fschroer/steam-pigeon-locator-hardware/BOM/RocketLocatorBOM.xlsx

Sheet: JLCPCB Upload
Comment | Designator | Footprint | JLCPCB Part #（optional）
2.2uF | C15,C16,C21 | C_0402_1005Metric | C307418
10nF | C17 | C_0402_1005Metric | C15195
10uF | C32,C37 | C_0402_1005Metric | C15525
1uF | C2,C3,C4,C5,C11,C12,C13,C14,C18,C38 | C_0402_1005Metric | C52923
0.1uF | C1,C6,C7,C8,C9,C10,C20,C36 | C_0402_1005Metric | C1525
47uF | C26 | C_1206_3216Metric | C96123
4.7uF | C19 | C_0402_1005Metric | C368809
Green LED | D1 | LED_0402_1005Metric | C965794
LED_XL-Z1912RGBA-SG | D4,D5 | LED_XL-Z1912RGBA-SG | C22461785
USB_C | J1 | USB_C_Receptacle_Palconn_UTC16-G | C2927038
U.FL-R-SMT(01) | J7 | HRS_U.FL-R-SMT(01) | C5137195
2N7002KN | Q1 | DFN1006-3L | C49009905
BSS84 | Q3 | DFN1006-3L | C42394022
PMXB43UNE | Q4,Q5,Q6,Q7 | Nexperia_DFN1010D-3_SOT1215 | C547273
5.1K | R10,R25 | R_0402_1005Metric | C294638
27K 0.1% | R11 | R_0402_1005Metric | C25207446
33 | R15 | R_0402_1005Metric | C25105
620 | R2,R18,R24,R36,R38 | R_0402_1005Metric | C4961
1M | R3,R17,R30 | R_0402_1005Metric | C26083
470 | R32 | R_0402_1005Metric | C25117
120 | R33,R34 | R_0402_1005Metric | C25079
47K | R27,R28,R37,R39 | R_0402_1005Metric | C25792
10K | R1,R12,R23,R26,R31,R40,R41 | R_0402_1005Metric | C25531
4.7K | R21,R22 | R_0402_1005Metric | C25900
100 | R4,R16,R19,R35,R43,R45,R46,R47,R48 | R_0402_1005Metric | C25076
47 | R5,R13,R14 | R_0402_1005Metric | C25118
220 | R6 | R_0402_1005Metric | C25091
374 | R7 | R_0402_1005Metric | C48971914
13K | R8 | R_0402_1005Metric | C25754
8.2K 0.1% | R9 | R_0402_1005Metric | C24265089
100K | R20,R29,R42,R44,R49,R50,R51,R52 | R_0402_1005Metric | C25741
1K | R53,R54,R55,R56 | R_0402_1005Metric | C11702
TPS22950YBHR | U1,U6,U8,U9,U15 | IC_TPS22950YBHR | C3230039
PAM8904EGPR | U11 | W-QFN2020-12-EP(2x2) | C510550
SN74HCS00BQA-Q1 | U12 | WQFN 14 3.00 mm × 2.50 mm | C4469587
DMP2021UFDF | U13 | Diodes_UDFN2020-6_Type-F | C151459
ISM6HG256XTR | U14 | U_LGA-14L_2p5X3p0X0p83_STM | C51931514
MS5611-01BA | U16 | LGA-8_3x5mm_P1.25mm | C15639
MX25L6436F | U17 | SOP-8_5.28x5.23mm_P1.27mm | C2830754
BQ25185DLHR | U18 | BQ25185DLHR | C19725033
SAM-M10Q-00B | U2 | XCVR_SAM-M10Q-00B | C5443880
DRV5032DUDMRR | U3 | X2SON | C2152495
CH340N | U4 | JEITA_SOIC-8_3.9x4.9mm_P1.27mm | C2977777
STM32WL5MOCH6TR | U5 | LGA-92_10X10_STM | C22363244
RT9080-33GJ5 | U7 | SOT94P280X100-5N | C841192
MMC5983MA | U19 | LGA-16_3x3mm_P0.5mm | C404329

Sheet: RocketLocator
Id | Designator | Footprint | Quantity | Comment | JLCPCB Part #（optional） | Type | Unit Cost | Total | Quantity on Hand | Attrition Quantity | Quantity Needed | Gap | Quantity Ordered | Order Status | Lead Time Estimate | Notes
1 | C15,C16,C21 | C_0402_1005Metric | 3 | 2.2uF | C307418 | Extended | 0.022 | $0.07 | 210 | 10 | 100 |  |  |  |  | X5R
2 | C17 | C_0402_1005Metric | 1 | 10nF | C15195 | Basic | 0.0041 | $0.0041 | 60 | 10 | 40 |  |  |  |  | X7R
3 | C32,C37 | C_0402_1005Metric | 2 | 10uF | C15525 | Basic | 0.0257 | $0.05 | 930 | 10 | 70 |  |  |  |  | X5R
4 | C2,C3,C4,C5,C11,C12,C13,C14,C18,C38 | C_0402_1005Metric | 10 | 1uF | C52923 | Basic | 0.0075 | $0.07 | 480 | 10 | 310 |  |  |  |  | X5R
5 | C1,C6,C7,C8,C9,C10,C20,C36 | C_0402_1005Metric | 8 | 0.1uF | C1525 | Basic | 0.0055 | $0.04 | 300 | 10 | 250 |  |  |  |  | X7R
6 | C26 | C_1206_3216Metric | 1 | 47uF | C96123 | Basic | 0.168 | $0.17 | 150 | 4 | 34 |  |  |  |  | X5R; JLCPCB now lists as Basic (was Extended)
7 | C19 | C_0402_1005Metric | 1 | 4.7uF | C368809 | Extended | 0.0157 | $0.02 | 500 |  | 30 |  |  |  |  | X5R
8 | D1 | LED_0402_1005Metric | 1 | Green LED | C965794 | Extended | 0.013 | $0.01 | 400 | 10 | 40
9 | D4,D5 | LED_XL-Z1912RGBA-SG | 2 | LED_XL-Z1912RGBA-SG | C22461785 | Extended | 0.0158 | $0.03 | 72 | 4 | 64 |  |  |  |  | JLCPCB part is XL-Z1921RGBA-SG; KiCad value/footprint say XL-Z1912RGBA-SG
10 | H1,H2,H3,H4 | MountingHole_2.2mm_M2 | 4 | MountingHole | N/A |  |  | $0.00 |  |  | 0
11 | J1 | USB_C_Receptacle_Palconn_UTC16-G | 1 | USB_C | C2927038 | Extended | 0.0635 | $0.06 | 257 |  | 30
12 | J12 | PinHeader_1x06_P2.54mm_Vertical_Pos4-5_Empty | 1 | Battery / Switch | N/A |  |  | $0.00 |  |  | 0
13 | J2 | PinHeader_1x04_P2.54mm_Vertical | 1 | Deploy Ch1 / Ch2 | N/A |  |  | $0.00 |  |  | 0
14 | J4 | PinHeader_1x04_P2.54mm_Vertical | 1 | Deploy Ch3 / Ch4 | N/A |  |  | $0.00 |  |  | 0
15 | J7 | HRS_U.FL-R-SMT(01) | 1 | U.FL-R-SMT(01) | C5137195 | Extended | 0.0417 | $0.04 | 279 |  | 30
16 | J8 | SAMTEC_FTR-107-51-G-D | 1 | Conn_ST_STDC14 | N/A |  |  | $0.00 |  |  | 0
17 | LS1 | PiezoBuzzer | 1 | SPKR | N/A |  |  | $0.00 |  |  | 0
18 | Q1 | DFN1006-3L | 1 | 2N7002KN | C49009905 | Extended | 0.0218 | $0.02 | 75 | 5 | 35
19 | Q3 | DFN1006-3L | 1 | BSS84 | C42394022 | Extended | 0.0403 | $0.04 | 42 | 4 | 34
20 | Q4,Q5,Q6,Q7 | Nexperia_DFN1010D-3_SOT1215 | 4 | PMXB43UNE | C547273 | Extended | 0.5428 | $2.17 |  | 4 | 124 | 124 |  |  |  | New: deploy low-side FETs (Topology A); PMXB43UNEZ, unit cost is LCSC 100+ price (Oct 2026)
21 | R10,R25 | R_0402_1005Metric | 2 | 5.1K | C294638 | Extended | 0.0014 | $0.0028 | 2930 | 10 | 70
22 | R11 | R_0402_1005Metric | 1 | 27K 0.1% | C25207446 | Extended | 0.0203 | $0.02 | 100 | 0 | 30
23 | R15 | R_0402_1005Metric | 1 | 33 | C25105 | Basic | 0.0011 | $0.0011 | 80 | 10 | 40 |  |  |  |  | Schematic value 35
24 | R2,R18,R24,R36,R38 | R_0402_1005Metric | 5 | 620 | C4961 | Extended | 0.0019 | $0.01 | 150 | 10 | 160 | 10
25 | R3,R17,R30 | R_0402_1005Metric | 3 | 1M | C26083 | Basic | 0.0015 | $0.0045 | 150 | 10 | 100
26 | R32 | R_0402_1005Metric | 1 | 470 | C25117 | Basic | 0.0012 | $0.0012 | 74 | 10 | 40
27 | R33,R34 | R_0402_1005Metric | 2 | 120 | C25079 | Basic | 0.0034 | $0.01 | 890 | 10 | 70
28 | R27,R28,R37,R39 | R_0402_1005Metric | 4 | 47K | C25792 | Basic | 0.002 | $0.01 | 150 | 10 | 130
29 | R1,R12,R23,R26,R31,R40,R41 | R_0402_1005Metric | 7 | 10K | C25531 | Extended | 0.0026 | $0.02 | 9705 | 12 | 222
30 | R21,R22 | R_0402_1005Metric | 2 | 4.7K | C25900 | Basic | 0.0021 | $0.0042 | 970 | 10 | 70
31 | R4,R16,R19,R35,R43,R45,R46,R47,R48 | R_0402_1005Metric | 9 | 100 | C25076 | Basic | 0.0012 | $0.01 | 960 | 10 | 280 |  |  |  |  | Schematic values R16=109, R19=98; R45-R48 are deploy FET gate resistors
32 | R5,R13,R14 | R_0402_1005Metric | 3 | 47 | C25118 | Extended | 0.0012 | $0.0036 | 2940 | 12 | 102
33 | R6 | R_0402_1005Metric | 1 | 220 | C25091 | Basic | 0.0018 | $0.0018 | 3030 | 10 | 40 |  |  |  |  | Schematic value 218
34 | R7 | R_0402_1005Metric | 1 | 374 | C48971914 | Extended | 0.0006 | $0.0006 | 60 | 10 | 40 |  |  |  |  | Schematic value 375
35 | R8 | R_0402_1005Metric | 1 | 13K | C25754 | Extended | 0.0023 | $0.0023 | 60 | 10 | 40
36 | R9 | R_0402_1005Metric | 1 | 8.2K 0.1% | C24265089 | Extended | 0.0213 | $0.02 | 100 | 10 | 40
37 | R20,R29,R42,R44,R49,R50,R51,R52 | R_0402_1005Metric | 8 | 100K | C25741 | Basic | 0.0015 | $0.01 | 4960 | 10 | 250 |  |  |  |  | R20 was 1M before Topology A; R49-R52 are deploy FET gate pulldowns
38 | R53,R54,R55,R56 | R_0402_1005Metric | 4 | 1K | C11702 | Basic | 0.0013 | $0.01 |  | 10 | 130 | 130 |  |  |  | New: DEPLOY1+..4+ bleeders (Topology A); unit cost is LCSC 100+ price (Oct 2026)
39 | U1,U6,U8,U9,U15 | IC_TPS22950YBHR | 5 | TPS22950YBHR | C3230039 | Extended | 0.5919 | $2.96 | 120 | 0 | 150 | 30
40 | U11 | W-QFN2020-12-EP(2x2) | 1 | PAM8904EGPR | C510550 | Extended | 0.3336 | $0.33 | 30 | 0 | 30
41 | U12 | WQFN 14 3.00 mm × 2.50 mm | 1 | SN74HCS00BQA-Q1 | C4469587 | Extended | 0.3679 | $0.37 | 50 | 0 | 30 |  |  |  |  | Replacing C295467
42 | U13 | Diodes_UDFN2020-6_Type-F | 1 | DMP2021UFDF | C151459 | Extended | 0.7504 | $0.75 | 0 | 0 | 30 | 30 | 34
43 | U14 | U_LGA-14L_2p5X3p0X0p83_STM | 1 | ISM6HG256XTR | C51931514 | Extended | 14.1006 | $14.10 | 30 | 0 | 30
44 | U16 | LGA-8_3x5mm_P1.25mm | 1 | MS5611-01BA | C15639 | Extended | 5.467 | $5.47 | 30 | 0 | 30
45 | U17 | SOP-8_5.28x5.23mm_P1.27mm | 1 | MX25L6436F | C2830754 | Extended | 2.0322 | $2.03 | 30 | 0 | 30
46 | U18 | BQ25185DLHR | 1 | BQ25185DLHR | C19725033 | Extended | 1.1346 | $1.13 | 0 | 0 | 30 | 30 | 30
47 | U2 | XCVR_SAM-M10Q-00B | 1 | SAM-M10Q-00B | C5443880 | Extended | 20.5582 | $20.56 | 30 | 0 | 30
48 | U3 | X2SON | 1 | DRV5032DUDMRR | C2152495 | Extended | 0.2927 | $0.29 | 60 | 0 | 30
49 | U4 | JEITA_SOIC-8_3.9x4.9mm_P1.27mm | 1 | CH340N | C2977777 | Extended | 0.4284 | $0.43 | 30 | 0 | 30
50 | U5 | LGA-92_10X10_STM | 1 | STM32WL5MOCH6TR | C22363244 | Extended | 24.6878 | $24.69 | 30 | 0 | 30
51 | U7 | SOT94P280X100-5N | 1 | RT9080-33GJ5 | C841192 | Extended | 0.1196 | $0.12 | 127 | 0 | 30
52 | U19 | LGA-16_3x3mm_P0.5mm | 1 | MMC5983MA | C404329 | Extended | 1.843 | $1.84 |  | 0 | 30 |  |  |  |  | Added 2026-10-21: magnetometer on I2C2 (0x30)

Sheet: Assumptions
Next production run quantity | 30
Unit cost source | JLCPCB parts API, 2026-10-21; price tier for each row's Quantity Needed (USD)
