fschroer/steam-pigeon-locator-hardware/RocketLocator.kicad_pcb

## KiCad design RocketLocator.kicad_pcb (2026-10-25)

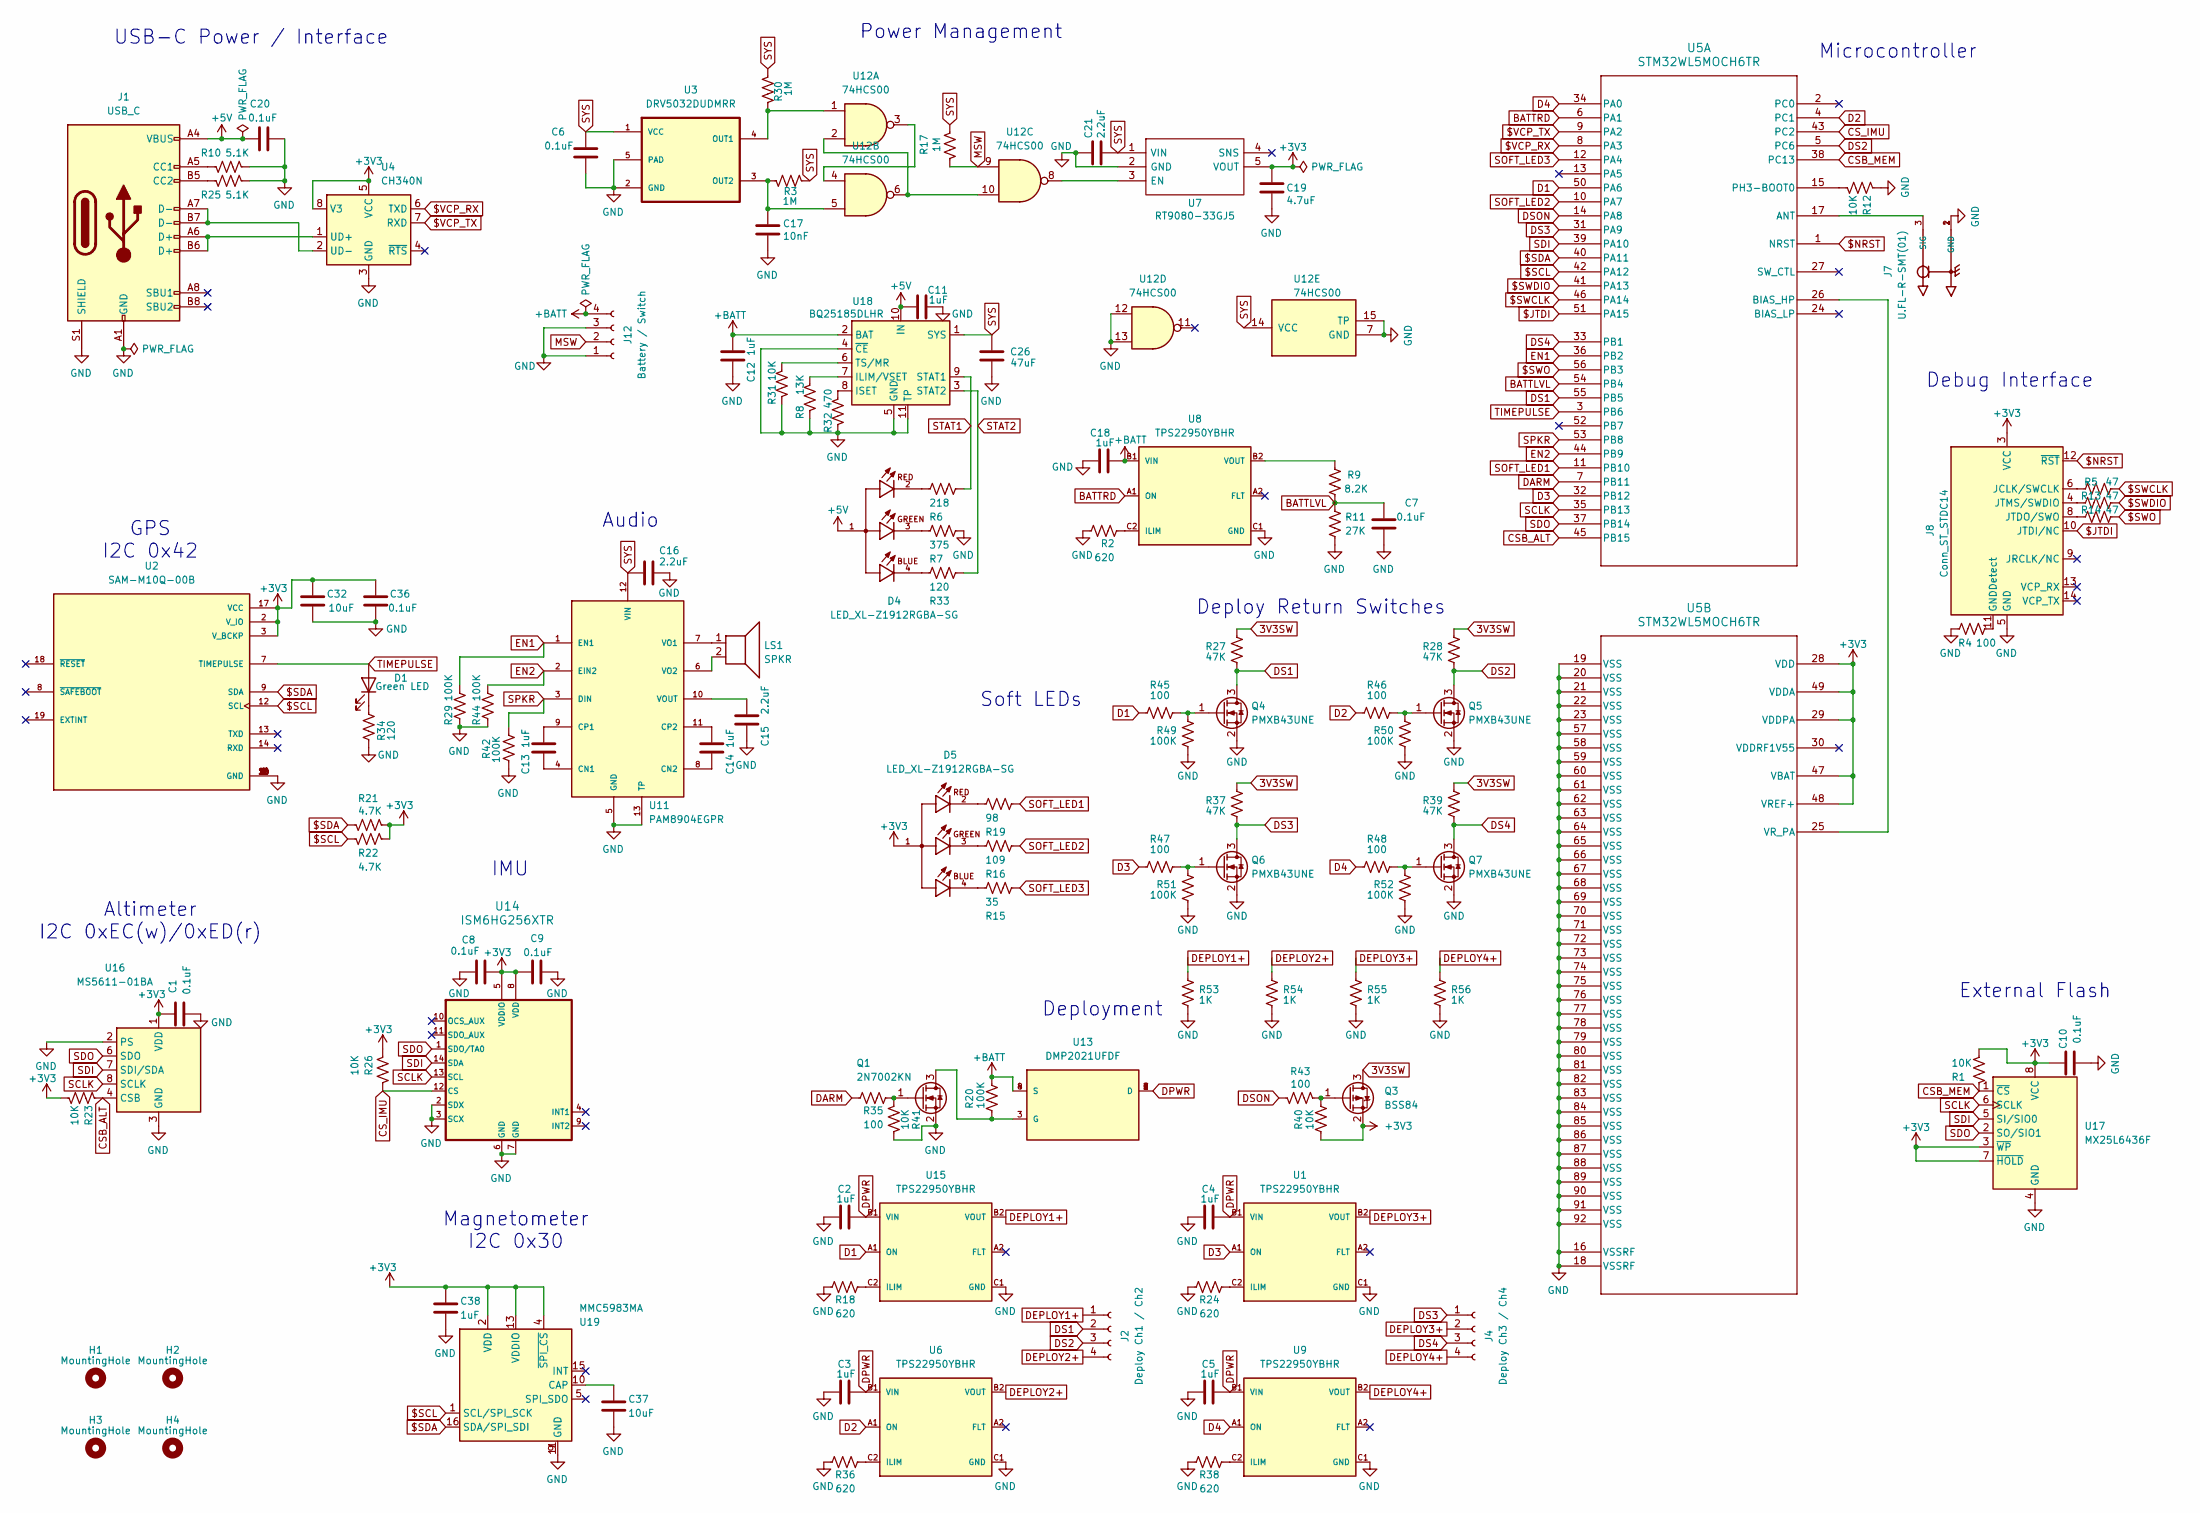
[picture p1: schematic RocketLocator.kicad_sch]

Parts:
C1, C6, C7, C8, C9, C10, C20, C36: 0.1uF; C_0402_1005Metric
C2, C3, C4, C5, C11, C12, C13, C14, C18, C38: 1uF; C_0402_1005Metric
C15, C16, C21: 2.2uF; C_0402_1005Metric
C17: 10nF; C_0402_1005Metric
C19: 4.7uF; C_0402_1005Metric
C26: 47uF; C_1206_3216Metric
C32, C37: 10uF; C_0402_1005Metric
D1: Green LED; LED_0402_1005Metric
D4, D5: LED_XL-Z1912RGBA-SG
H1, H2, H3, H4: MountingHole; MountingHole_2.2mm_M2
J1: USB_C; USB_C_Receptacle_Palconn_UTC16-G
J2: Deploy Ch1 / Ch2; PinHeader_1x04_P2.54mm_Vertical
J4: Deploy Ch3 / Ch4; PinHeader_1x04_P2.54mm_Vertical
J7: U.FL-R-SMT(01); HRS_U.FL-R-SMT(01)
J8: Conn_ST_STDC14; SAMTEC_FTR-107-51-G-D
J12: Battery / Switch; PinHeader_1x06_P2.54mm_Vertical_Pos4-5_Empty
LS1: SPKR; PiezoBuzzer
Q1: 2N7002KN; DFN1006-3L
Q3: BSS84; DFN1006-3L
Q4, Q5, Q6, Q7: PMXB43UNE; Nexperia_DFN1010D-3_SOT1215
R1, R12, R23, R26, R31, R40, R41: 10K; R_0402_1005Metric
R2, R18, R24, R36, R38: 620; R_0402_1005Metric
R3, R17, R30: 1M; R_0402_1005Metric
R4, R35, R43, R45, R46, R47, R48: 100; R_0402_1005Metric
R5, R13, R14: 47; R_0402_1005Metric
R6: 218; R_0402_1005Metric
R7: 375; R_0402_1005Metric
R8: 13K; R_0402_1005Metric
R9: 8.2K; R_0402_1005Metric
R10, R25: 5.1K; R_0402_1005Metric
R11: 27K; R_0402_1005Metric
R15: 35; R_0402_1005Metric
R16: 109; R_0402_1005Metric
R19: 98; R_0402_1005Metric
R20, R29, R42, R44, R49, R50, R51, R52: 100K; R_0402_1005Metric
R21, R22: 4.7K; R_0402_1005Metric
R27, R28, R37, R39: 47K; R_0402_1005Metric
R32: 470; R_0402_1005Metric
R33, R34: 120; R_0402_1005Metric
R53, R54, R55, R56: 1K; R_0402_1005Metric
U1, U6, U8, U9, U15: TPS22950YBHR; IC_TPS22950YBHR
U2: SAM-M10Q-00B; XCVR_SAM-M10Q-00B; PARTREV R03
U3: DRV5032DUDMRR; X2SON
U4: CH340N; JEITA_SOIC-8_3.9x4.9mm_P1.27mm
U5: STM32WL5MOCH6TR; LGA-92_10X10_STM
U7: RT9080-33GJ5; SOT94P280X100-5N; Manufacturer_Part_Number RT9080-33GJ5
U11: PAM8904EGPR; W-QFN2020-12-EP(2x2)
U12: 74HCS00; WQFN 14 3.00 mm × 2.50 mm
U13: DMP2021UFDF; Diodes_UDFN2020-6_Type-F
U14: ISM6HG256XTR; U_LGA-14L_2p5X3p0X0p83_STM
U16: MS5611-01BA; LGA-8_3x5mm_P1.25mm
U17: MX25L6436F; SOP-8_5.28x5.23mm_P1.27mm
U18: BQ25185DLHR
U19: MMC5983MA; LGA-16_3x3mm_P0.5mm

Connections:
3V3SW: Q3.3 (D), R27.1, R28.2, R37.1, R39.2
$JTDI: J8.10 (JTDI/NC), U5.51 (PA15)
$NRST: J8.12 (~RST), U5.1 (NRST)
$SCL: R22.2, U2.12 (SCL), U5.42 (PA12), U19.1 (SCL/SPI_SCK)
$SDA: R21.2, U2.9 (SDA), U5.40 (PA11), U19.16 (SDA/SPI_SDI)
$SWCLK: R5.1, U5.46 (PA14)
$SWDIO: R13.1, U5.41 (PA13)
$SWO: R14.1, U5.56 (PB3)
$VCP_RX: U4.6 (TXD), U5.8 (PA3)
$VCP_TX: U4.7 (RXD), U5.9 (PA2)
+3V3: C1.1, C8.2, C9.1, C10.1, C19.1, C32.1, C36.2, C38.1, D5.1, J8.3 (VCC), Q3.2 (S), R1.2, R21.1, R22.1, R23.2, R26.2, R40.2, U2.2 (V_IO), U2.3 (V_BCKP), U2.17 (VCC), U4.5 (VCC), U4.8 (V3), U5.28 (VDD), U5.29 (VDDPA), U5.47 (VBAT), U5.48 (VREF+), U5.49 (VDDA), U7.5 (VOUT), U14.5 (VDDIO), U14.8 (VDD), U16.1 (VDD), U17.3 (~WP), U17.7 (~HOLD), U17.8 (VCC), U19.2 (VDD), U19.4 (~SPI_CS), U19.13 (VDDIO)
+5V: C11.1, C20.1, D4.1, J1.A4 (VBUS), J1.A9 (VBUS), J1.B4 (VBUS), J1.B9 (VBUS), U18.10 (IN)
+BATT: C12.2, C18.2, J12.4, R20.1, U8.B1 (VIN), U13.4 (S), U13.8 (S), U18.2 (BAT)
BATTLVL: C7.1, R9.1, R11.1, U5.54 (PB4)
BATTRD: U5.6 (PA1), U8.A1 (ON)
CSB_ALT: R23.1, U5.45 (PB15), U16.4 (CSB), U16.5 (CSB)
CSB_MEM: R1.1, U5.38 (PC13), U17.1 (~CS)
CS_IMU: R26.1, U5.43 (PC2), U14.12 (CS)
D1: R45.2, U5.50 (PA6), U15.A1 (ON)
D2: R46.2, U5.4 (PC1), U6.A1 (ON)
D3: R47.2, U1.A1 (ON), U5.32 (PB12)
D4: R48.2, U5.34 (PA0), U9.A1 (ON)
DARM: R35.1, U5.7 (PB11)
DEPLOY1+: J2.1, R53.1, U15.B2 (VOUT)
DEPLOY2+: J2.4, R54.1, U6.B2 (VOUT)
DEPLOY3+: J4.2, R55.1, U1.B2 (VOUT)
DEPLOY4+: J4.4, R56.1, U9.B2 (VOUT)
DPWR: C2.2, C3.2, C4.2, C5.2, U1.B1 (VIN), U6.B1 (VIN), U9.B1 (VIN), U13.1 (D), U13.2 (D), U13.5 (D), U13.6 (D), U13.7 (D), U15.B1 (VIN)
DS1: J2.2, Q4.3 (D), R27.2, U5.55 (PB5)
DS2: J2.3, Q5.3 (D), R28.1, U5.5 (PC6)
DS3: J4.1, Q6.3 (D), R37.2, U5.31 (PA9)
DS4: J4.3, Q7.3 (D), R39.1, U5.33 (PB1)
DSON: R43.1, U5.14 (PA8)
EN1: R29.2, U5.36 (PB2), U11.1 (EN1)
EN2: R44.2, U5.44 (PB9), U11.2 (EIN2)
GND: C1.2, C2.1, C3.1, C4.1, C5.1, C6.2, C7.2, C8.1, C9.2, C10.2, C11.2, C12.1, C15.1, C16.1, C17.1, C18.1, C19.2, C20.2, C21.1, C26.1, C32.2, C36.1, C37.2, C38.2, J1.A1 (GND), J1.A12 (GND), J1.B1 (GND), J1.B12 (GND), J1.S1 (SHIELD), J7.1 (GND), J7.2 (GND), J8.5 (GND), J8.7 (GND), J12.1, J12.3, Q1.2 (S), Q4.2 (S), Q5.2 (S), Q6.2 (S), Q7.2 (S), R2.1, R4.2, R7.1, R8.1, R10.2, R11.2, R12.1, R18.1, R24.1, R25.2, R29.1, R31.1, R32.1, R34.1, R36.1, R38.1, R41.2, R42.1, R44.1, R49.2, R50.2, R51.2, R52.2, R53.2, R54.2, R55.2, R56.2, U1.C1 (GND), U2.1 (GND), U2.4 (GND), U2.5 (GND), U2.6 (GND), U2.10 (GND), U2.11 (GND), U2.15 (GND), U2.16 (GND), U2.20 (GND), U3.2 (GND), U3.5 (PAD), U4.3 (GND), U5.16 (VSSRF), U5.18 (VSSRF), U5.19 (VSS), U5.20 (VSS), U5.21 (VSS), U5.22 (VSS), U5.23 (VSS), U5.57 (VSS), U5.58 (VSS), U5.59 (VSS), U5.60 (VSS), U5.61 (VSS), U5.62 (VSS), U5.63 (VSS), U5.64 (VSS), U5.65 (VSS), U5.66 (VSS), U5.67 (VSS), U5.68 (VSS), U5.69 (VSS), U5.70 (VSS), U5.71 (VSS), U5.72 (VSS), U5.73 (VSS), U5.74 (VSS), U5.75 (VSS), U5.76 (VSS), U5.77 (VSS), U5.78 (VSS), U5.79 (VSS), U5.80 (VSS), U5.81 (VSS), U5.82 (VSS), U5.83 (VSS), U5.84 (VSS), U5.85 (VSS), U5.86 (VSS), U5.87 (VSS), U5.88 (VSS), U5.89 (VSS), U5.90 (VSS), U5.91 (VSS), U5.92 (VSS), U6.C1 (GND), U7.2 (GND), U8.C1 (GND), U9.C1 (GND), U11.5 (GND), U11.13 (TP), U12.7 (GND), U12.12, U12.13, U12.15 (TP), U14.2 (SDX), U14.3 (SCX), U14.6 (GND), U14.7 (GND), U15.C1 (GND), U16.2 (PS), U16.3 (GND), U17.4 (GND), U18.4 (~CE), U18.5 (GND), U18.11 (TP), U19.9 (GND), U19.11 (GND)
MSW: J12.2, R17.2, U12.9
unnamed: D1.1 (K), R34.2
unnamed: D4.2, R6.2
unnamed: D4.3, R7.2
unnamed: D4.4, R33.2
unnamed: D5.2, R19.2
unnamed: D5.3, R16.2
unnamed: D5.4, R15.2
unnamed: J1.A5 (CC1), R10.1
unnamed: J1.B5 (CC2), R25.1
unnamed: J7.3 (SIG), U5.17 (ANT)
unnamed: J8.11 (GNDDetect), R4.1
unnamed: J8.6 (JCLK/SWCLK), R5.2
unnamed: J8.8 (JTDO/SWO), R14.2
unnamed: J8.4 (JTMS/SWDIO), R13.2
unnamed: Q1.3 (D), R20.2, U13.3 (G)
unnamed: Q1.1 (G), R35.2, R41.1
unnamed: Q3.1 (G), R40.1, R43.2
unnamed: Q4.1 (G), R45.1, R49.1
unnamed: Q5.1 (G), R46.1, R50.1
unnamed: Q6.1 (G), R47.1, R51.1
unnamed: Q7.1 (G), R48.1, R52.1
unnamed: R24.2, U1.C2 (ILIM)
unnamed: R30.2, U3.4 (OUT1), U12.1
unnamed: C17.2, R3.2, U3.3 (OUT2), U12.5
unnamed: J1.A6 (D+), J1.B6 (D+), U4.1 (UD+)
unnamed: J1.A7 (D-), J1.B7 (D-), U4.2 (UD-)
unnamed: U5.25 (VR_PA), U5.26 (BIAS_HP)
unnamed: R12.2, U5.15 (PH3-BOOT0)
unnamed: R36.2, U6.C2 (ILIM)
unnamed: U7.3 (EN), U12.8
unnamed: R2.2, U8.C2 (ILIM)
unnamed: R9.2, U8.B2 (VOUT)
unnamed: R38.2, U9.C2 (ILIM)
unnamed: C13.1, U11.4 (CN1)
unnamed: C14.1, U11.8 (CN2)
unnamed: C13.2, U11.9 (CP1)
unnamed: C14.2, U11.11 (CP2)
unnamed: LS1.1, U11.7 (VO1)
unnamed: LS1.2, U11.6 (VO2)
unnamed: C15.2, U11.10 (VOUT)
unnamed: U12.3, U12.4
unnamed: U12.2, U12.6, U12.10
unnamed: R18.2, U15.C2 (ILIM)
unnamed: R8.2, U18.7 (ILIM/VSET)
unnamed: R32.2, U18.8 (ISET)
unnamed: R31.2, U18.6 (TS/MR)
unnamed: C37.1, U19.10 (CAP)
SCLK: U5.35 (PB13), U14.13 (SCL), U16.8 (SCLK), U17.6 (SCLK)
SDI: U5.39 (PA10), U14.14 (SDA), U16.7 (SDI/SDA), U17.5 (SI/SIO0)
SDO: U5.37 (PB14), U14.1 (SDO/TA0), U16.6 (SDO), U17.2 (SO/SIO1)
SOFT_LED1: R19.1, U5.11 (PB10)
SOFT_LED2: R16.1, U5.10 (PA7)
SOFT_LED3: R15.1, U5.12 (PA4)
SPKR: R42.2, U5.53 (PB8), U11.3 (DIN)
STAT1: R6.1, U18.9 (STAT1)
STAT2: R33.1, U18.3 (STAT2)
SYS: C6.1, C16.2, C21.2, C26.2, R3.1, R17.1, R30.1, U3.1 (VCC), U7.1 (VIN), U11.12 (VIN), U12.14 (VCC), U18.1 (SYS)
TIMEPULSE: D1.2 (A), U2.7 (TIMEPULSE), U5.3 (PB6)

Notes on the sheet:
Deployment
Debug Interface
Deploy Return Switches
Soft LEDs
USB-C Power / Interface
Audio
GPS I2C 0x42
Magnetometer I2C 0x30
Power Management
External Flash
Altimeter I2C 0xEC(w)/0xED(r)
Microcontroller
IMU

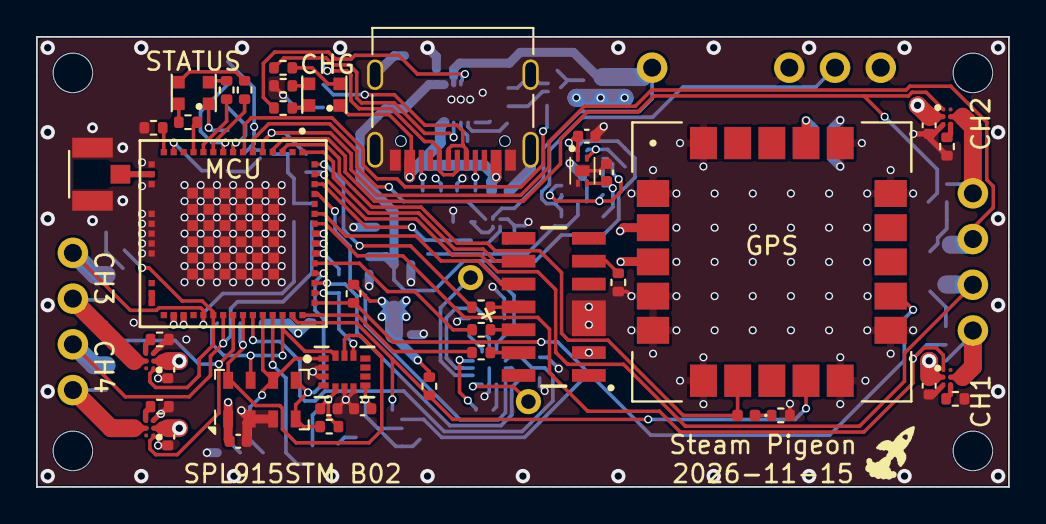
[picture p2: board RocketLocator.kicad_pcb from above]

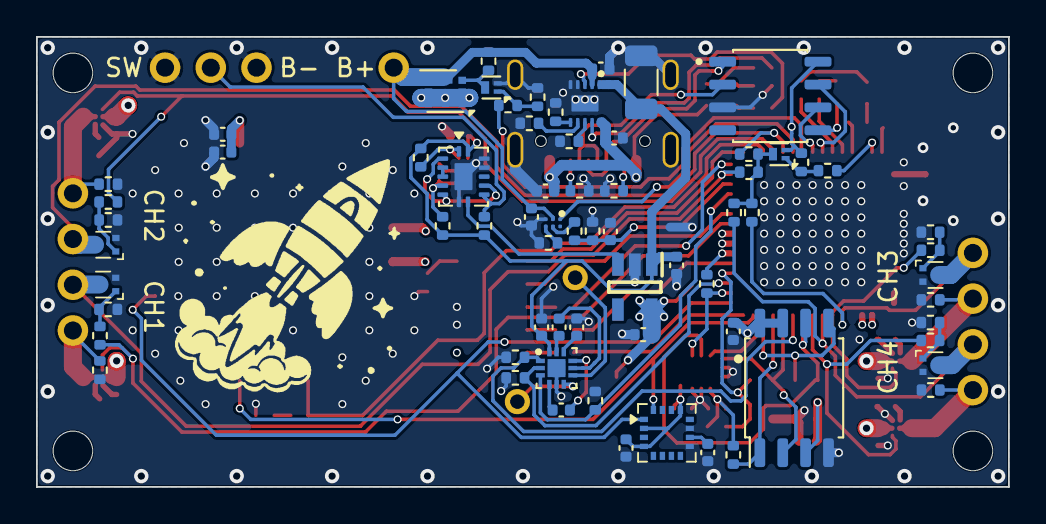
[picture p3: board RocketLocator.kicad_pcb from below]

Board: 4 copper layers, 54.0 x 25.0 mm, 122 parts (70 on the bottom side), 95 nets.

Other parts of the board:
G1: SteamPigeon_Logo_13mm
G2: SteamPigeon_Logo_3mm
