fschroer/steam-pigeon-locator-hardware/(commit log)

2026-10-15 Initial import of RocketLocator B01 design with repo scaffolding
    Design files are the KiCad 10 project as of 2026-06-04 (board SPL915STM B01).
    Adds README, .gitignore for KiCad caches, backups and generated outputs, and a
    kicad-cli workflow that runs ERC/DRC and builds fab outputs, attaching them to
    a release on board tags.
    Claude-Session: https://claude.ai/code/session_01C1wUevCmefHv8PBPpeosyX
    [RocketLocator.kicad_pcb, RocketLocator.kicad_sch]
2026-10-16 Bundle project symbol and footprint libraries (#10)
    * Bundle project symbol and footprint libraries
    Adds the Custom symbol and footprint libraries from the personal KiCad 9.0
    library folder, plus RT9080-33GJ5, STM32WL5MOCH6TR and U.FL-R-SMT_01_
    symbols extracted from the schematic's embedded cache. Registers them in
    project lib tables via ${KIPRJMOD} and adds a CI step that loads every
    library so a broken file fails the build.
    * Recover U7 and U17 footprints into Custom.pretty and relink
    The RT9080 and Package_SO_New libraries are gone, so the footp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
    [RocketLocator.kicad_pcb, RocketLocator.kicad_sch]
2026-10-16 Switch deploy returns low-side so continuity sense works (Topology A)
    Each deploy channel's e-match return (J2/J4 pins 2 and 4) now goes through
    an AO3400A low-side N-FET (Q4-Q7) instead of straight to GND. The gate is
    driven from the same Dn GPIO as the TPS22950 ON pin through 100R, with a
    100K pull-down. The DSn sense net and its existing 47K pull-up (R27, R28,
    R37, R39) move to the FET drain, so the TPS22950 quick output discharge no
    longer pins the sense node low. Each TPS22950 output (now DEPLOYn+) gets a
    1K bleeder to GND (R53-R56).
    The Soft LEDs block moved 25.4 mm left to make room for the new block.
    The PCB still needs Update PCB from Schematic, placement and routing.
    Fixes #1
    Co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
    [RocketLocator.kicad_sch]
2026-10-19 Use PMXB43UNE (DFN1010D-3) for the deploy return switches
    Q4-Q7 change from AO3400A (SOT-23) to Nexperia PMXB43UNE: 20 V, 3.2 A,
    68 mOhm max at Vgs 2.5 V, 1.1 x 1.0 mm, so two fit beside J4 on the
    bottom side. Adds lib/Custom.pretty/Nexperia_DFN1010D-3_SOT1215 built
    from the datasheet's reflow footprint (Fig. 20): 0.35 x 0.4 mm lands,
    0.25 x 0.3 mm paste, 0.45 x 0.5 mm resist; the centre drain bar has no
    land. Symbol is the stock Transistor_FET:Q_NMOS_GSD (1=G, 2=S, 3=D).
    Also turns the bleeder DEPLOYn+ labels horizontal so they no longer
    overlap the GND symbols above them.
    Claude-Session: https://claude.ai/code/session_0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
    [RocketLocator.kicad_sch]
2026-10-20 Fix malformed U5 (LGA-92) courtyard in library footprint
    The imported STM32WL5MOC footprint drew its courtyard as 20 short
    F.CrtYd segments, several of them zero-length, which DRC reports as a
    self-intersecting / not closed courtyard. Replace them with a single
    10.608 mm square rectangle covering the same outline.
    Claude-Session: https://claude.ai/code/session_01MkgwVw8wg6ywYfkGV7BwAK
2026-10-20 Swap J2/J4 deploy pinout, lower arm-gate pull-up, fix DRC errors
    Schematic:
    - J2 ch2 and J4 ch3/ch4 pin order changed: J2 pin 3 = DS2,
    pin 4 = DEPLOY2+; J4 pin 1 = DS3, pin 2 = DEPLOY3+, pin 3 = DS4,
    pin 4 = DEPLOY4+.
    - R20 (U13 arm FET gate pull-up) 1M -> 100K.
    PCB:
    - Rerouted the deploy connectors for the new pinout.
    - Connected Q5 pad 2 GND, which sat on an isolated B.Cu pour island
    (DRC "missing connection" on the GND zone).
    - Updated U5 from the fixed LGA-92 library footprint (malformed
    courtyard errors).
    DRC now reports no errors and no unconnected items. The remaining
    ERC errors predate this change.
    [RocketLocator.kicad_pcb, RocketLocator.kicad_sch]
2026-10-20 Clear ERC errors: U14 pin types, U8 FLT no-connect
    - ISM6HG256XTR (U14), in lib/Custom.kicad_sym and the schematic's
    embedded copy: pin 1 SDO/TA0 Output -> Bidirectional (SPI data out
    and I2C address-select input), which clears the output-output
    conflict with U16 SDO on the shared SPI bus; pins 6/7 GND
    Power output -> Power input.
    - Added a no-connect flag on U8 pin A2 (FLT), matching the other
    TPS22950 switches.
    ERC now reports 0 errors. No nets changed, so the PCB is untouched.
    [RocketLocator.kicad_sch]
2026-10-20 Add purchasing BOM updated for Topology A deploy parts
    Adds the hand-maintained RocketLocatorBOM.xlsx under BOM/ and brings it
    in line with the current schematic:
    - New Q4-Q7 PMXB43UNE (C547273) and R53-R56 1K bleeders (C11702)
    - R45-R48 100R gate resistors added to the 100R row
    - R49-R52 gate pulldowns and R20 (now 100K) moved to the 100K row
    - J16-J20/J25 test points removed (no longer in the design)
    - J7 and U12 footprint names matched to KiCad, stray space in R11 part #
    - Notes on LED resistors whose schematic values differ from the
    purchased standard values (R6, R7, R15, R16, R19)
    - JLCPCB Upload sheet regenerated from the main table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
    [RocketLocatorBOM.xlsx]
2026-10-20 Fill in unit costs for the new Topology A BOM parts
    Q4-Q7 PMXB43UNEZ (C547273) at $0.5441 and R53-R56 1K (C11702) at
    $0.0013, both LCSC 100+ pricing. Re-checked every designator, value and
    footprint against the current schematic and PCB: all 118 placed parts
    are accounted for, with no extra or missing rows.
    [RocketLocatorBOM.xlsx]
2026-10-21 Fix BOM workbook that Excel reported as corrupt
    The query table's defined name (ExternalData_1) still covered
    A1:E53 after a row was added, so it no longer matched the
    RocketLocator table (A1:Q54). Excel treats that mismatch as file
    corruption. Extend it to A1:E54.
    Claude-Session: https://claude.ai/code/session_01Qn4Fhe37cECFfk8PPTy8Kj
    [RocketLocatorBOM.xlsx]
2026-10-21 Price the BOM from JLCPCB
    Unit Cost and Type for every orderable row now come from JLCPCB's parts
    API (2026-10-21), using the price tier that matches each row's Quantity
    Needed. Assumptions sheet records the source and date. Notes flag C7
    (C2981728) out of stock at JLCPCB with a 30-piece gap, C26 now Basic,
    and the D4/D5 part (C22461785) being XL-Z1921RGBA-SG while KiCad says
    XL-Z1912RGBA-SG.
    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
    [RocketLocatorBOM.xlsx]
2026-10-21 Move C7 (BATTLVL filter) to 0402 X7R
    C7 only filters the battery-sense divider node (max ~3.2 V), so the
    out-of-stock 50 V C0G 1206 part is not needed. Swap it to the same
    0.1uF 0402 X7R as the other decoupling caps (C1525):
    - Schematic footprint Capacitor_SMD:C_0402_1005Metric
    - PCB: 0402 placed vertically on B.Cu at (41.775, 30.16) on the
    existing BATTLVL node; GND pad picks up the B.Cu pour. Old GND stub
    removed, zones refilled. DRC: 0 errors, 0 unconnected, schematic
    parity clean.
    - BOM: C7 merged into the 0.1uF row, its own row removed.
    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
    [RocketLocator.kicad_pcb, RocketLocator.kicad_sch, RocketLocatorBOM.xlsx]
2026-10-21 Reposition components (Frank's layout changes)
    [RocketLocator.kicad_pcb]
2026-10-21 Remove dangling DEPLOYn+ track stubs; ignore footprint filter check
    Four 0.14 mm F.Cu stubs on DEPLOY1+..4+ ended in free space. The
    footprint-filter warnings only say the Custom footprints don't match
    the stock symbols' filter text, so that check is set to ignore.
    DRC: 0 errors, 0 unconnected.
    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
    [RocketLocator.kicad_pcb]
2026-10-21 Hide reference labels on deploy parts Q4-Q7, R45-R56
    Their 0.5 mm labels overlapped each other and the pads around J2/J4 and
    were below the 0.8 mm silk text minimum. Clears 59 silk/text warnings.
    DRC: 0 errors, 0 unconnected, 85 warnings.
    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
    [RocketLocator.kicad_pcb]
2026-10-21 Update 0402 R/C and LED footprints from KiCad library
    [RocketLocator.kicad_pcb]
2026-10-21 Add MMC5983MA magnetometer on I2C2
    U19 MMC5983MA (JLCPCB C404329) joins the GPS I2C bus at 0x30 with
    SPI_CS tied to VDDIO for I2C mode. C38 1uF on VDD, C39 0.1uF on VDDIO,
    C37 10uF on CAP for the SET/RESET pulse. INT and SPI_SDO left unconnected.
    Footprint is KiCad's stock Package_LGA:LGA-16_3x3mm_P0.5mm, which matches
    the datasheet land pattern. New Custom:MMC5983MA symbol. BOM updated.
    Claude-Session: https://claude.ai/code/session_01FYY8Uv6gBjRSv3QTZNtnYK
    [RocketLocator.kicad_sch, RocketLocatorBOM.xlsx]
2026-10-22 Schematic layout tweaks by Frank
    [RocketLocator.kicad_sch]
2026-10-22 Drop C39 VDDIO bypass cap to match MMC5983MA datasheet
    The datasheet application circuit has only 1uF on VDD (C38) and 10uF on
    CAP (C37); VDD and VDDIO share +3V3 here, so C38 covers both.
    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
    [RocketLocator.kicad_sch, RocketLocatorBOM.xlsx]
2026-10-23 Place magnetometer U19 and reroute (Frank, after KiCad crash)
    [RocketLocator.kicad_pcb]
2026-10-23 Restore post-crash PCB fixes from PR #13
    KiCad crashed during U19 placement and the saved board lost several
    fixes that were merged in PR #13. Re-apply them without touching the
    new placement or routing:
    - Re-sync footprints (0402 R/C/LED library updates, hidden Q4-Q7 and
    R45-R56 reference labels, LGA-92 courtyard) from main, keeping the
    current position, side and rotation of every part.
    - Remove the dangling DEPLOY1+..4+ stub tracks and the orphan SYS via.
    - Refill zones.
    DRC: 14 intentional warnings (as on main, minus two silk items) and
    1 unconnected item: Q5 pad 2 (GND) sits in an isolated B.Cu island
    after Q5 was rotated to 180 degrees. Left for manual rerouting.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
    [RocketLocator.kicad_pcb]
2026-10-24 Space J12 battery pins and drop J3
    J3 ("Battery-") was a separate pad so the battery leads could be
    soldered apart. Return current through it ran along the bottom edge
    past the U19 magnetometer. Instead, J12 now uses a 1x06 outline with
    pads at positions 1-3 and 6 only, so +BATT sits 7.6 mm from the nearest
    GND pad and every battery return enters at the top edge.
    - New footprint Custom:PinHeader_1x06_P2.54mm_Vertical_Pos4-5_Empty.
    Pad numbers and nets are unchanged (1 GND, 2 MSW, 3 GND, 4 +BATT).
    Pad 4 is moved to position 6.
    - Remove J3 and its GND symbol from the schematic.
    - BOM: J12 footprint updated, J3 row removed (table now A1:Q53).
    The PCB is not updated in this commit; run Upd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
    [RocketLocator.kicad_sch, RocketLocatorBOM.xlsx]
2026-10-24 Board: U18 thermal vias, straight Ch4 DPWR feed (Frank)
    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
    [RocketLocator.kicad_pcb]
2026-10-25 Board: place spaced J12, remove J3 (Frank)
    J12 at (66.88, 21.71) rot -90 with the new 1x06 outline: +BATT stays
    at x=54.18, GND/MSW/GND at 61.80/64.34/66.88. MSW rerouted, J3 deleted.
    DRC: 0 errors, 0 unconnected, 0 parity issues, 14 intentional warnings.
    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
    [RocketLocator.kicad_pcb]
2026-10-25 Add Steam Pigeon app logo to bottom silkscreen
    New footprint Custom:SteamPigeon_Logo_13mm (12.8 x 13.1 mm, B.SilkS when
    placed on the back) traced from the steam-pigeon-ios AppIcon: filled
    artwork with the drawing's outlines as knockouts, min line/gap ~0.18 mm.
    Board-only, excluded from BOM/CPL, courtyard not required.
    Placed as G1 on the bottom at (58.8, 32.6) in the open area left of U12.
    DRC unchanged from main.
    Claude-Session: https://claude.ai/code/session_012mcqyg5z3e1rRwnuuyV256
    [RocketLocator.kicad_pcb]
2026-10-25 Add small Steam Pigeon logo to top silkscreen
    New footprint Custom:SteamPigeon_Logo_3mm (2.8 x 3.0 mm): a simplified
    silhouette of the app logo (rocket, wings, exhaust cloud, window
    knockout) with stars and fine interior lines dropped so every line and
    gap is at least 0.15 mm. Board-only, excluded from BOM/CPL.
    Placed as G2 on the top at (67.4, 43.1), right of the "Steam Pigeon"
    text block. DRC unchanged (14 pre-existing violations).
    [RocketLocator.kicad_pcb]
2026-10-25 Board: logo placement tweaks (Frank)
    [RocketLocator.kicad_pcb]
